claudiusmarius/ECHANGES-AVEC-NBTV-CLUB-DFTA500/Schematic_DFTA282_2026-09-18.pdf

TP2 | TP10

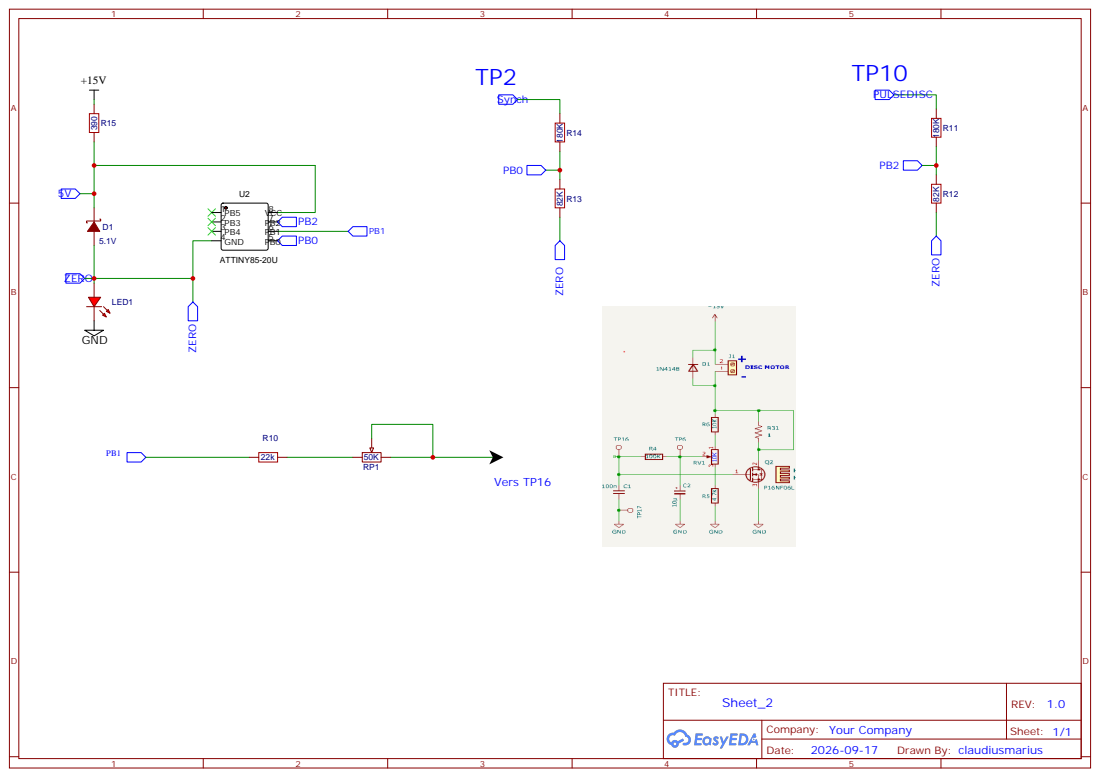
[picture p8: page 1]
